MatiPardoE/CoffeeScale/7.Maqueta3D/README.md

# CoffeeScale

## Link del modelo 3d: [Coffee Scale](https://cad.onshape.com/documents/d358b07a945924bf26fd07b2/w/ca354c555462849854da787c/e/e62f95f824919a2ad912569b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)

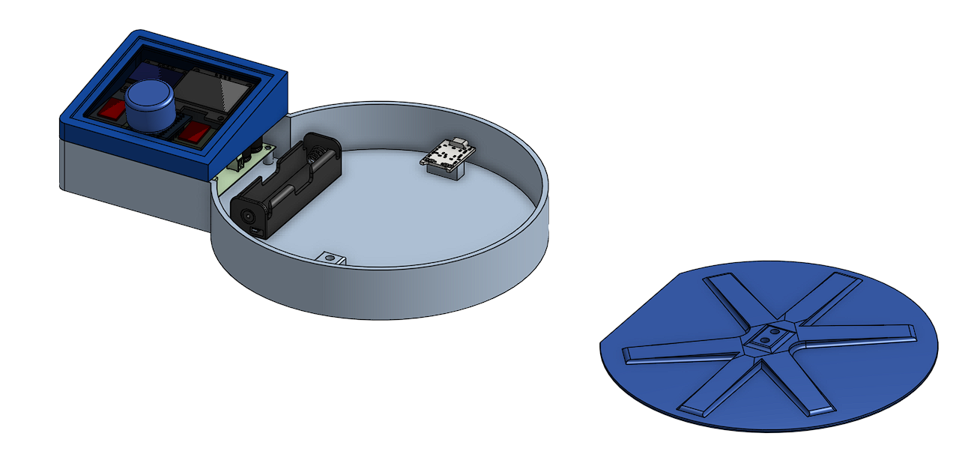
[picture p1: 7.Maqueta3D/ScreenShot.png]
Maqueta en 3d
