MatiPardoE/CoffeeScale/4.esquematico_pcb/CoffeeScale/Project Outputs for CoffeeScale/Entrega PCB/3D Picture.png

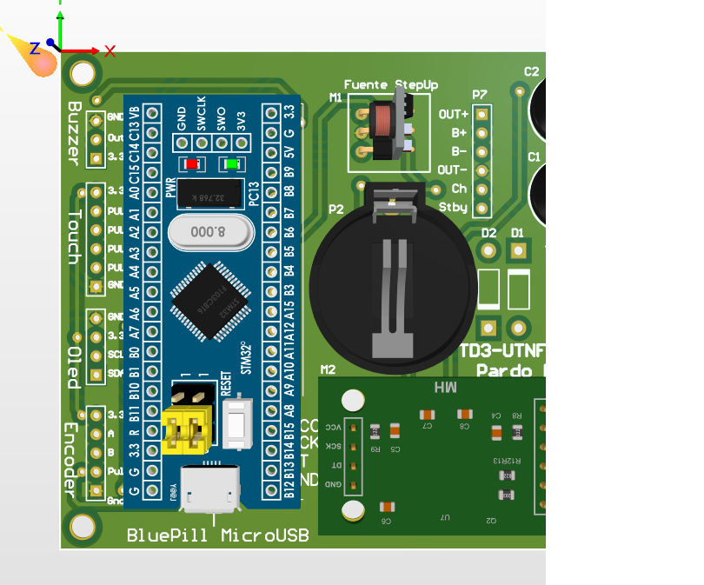
4.esquematico_pcb/CoffeeScale/Project Outputs for CoffeeScale/Entrega PCB/3D Picture.png
