MatiPardoE/CoffeeScale/1.preliminar/PriceList.xlsx

CoffeeScale
DATE
Done? | Item | Category | Quantity | Price | Extended Price | Brand/Comments
Yes | Sensor Touch | Electronic Module | 3 | $560.00 | $1680.00
Yes | Holder 18650 | Electronic Module | 1 | $999.00 | $999.00
Yes | Display Oled 1.3 | Electronic Module | 1 | $4419.00 | $4419.00
Yes | TP4056 Type C | Electronic Module | 1 | $1039.00 | $1039.00
Yes | Load Cell 3Kg | Sensor | 1 | $2369.00 | $2369.00
Yes | HX711 | Electronic Module | 1 | $900.00 | $900.00
Yes | 18650 Battery | Power | 1 | $3400.00 | $3400.00
No | Buzzer Magntic 5V | Audio | 1 | $760.00 | $760.00 | https://articulo.mercadolibre.com.ar/MLA-705919933-modulo-buzzer-activo-3v3-5v-zumbador-arduino-nubbeo-_JM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
 |  |  |  |  | $0.00
 |  |  |  |  | $0.00
 |  |  |  |  | $0.00
 |  |  |  |  | $0.00
 |  |  |  |  | $0.00
 |  |  |  |  | $0.00
 |  |  |  |  | $0.00
 |  |  |  |  | $0.00
 |  |  |  |  | $0.00
 |  |  |  |  | $0.00
 |  |  |  |  | $0.00
 |  |  |  |  | $0.00
 |  |  |  |  | $0.00
 |  |  |  |  | $0.00
 |  |  |  |  | $0.00
 |  |  |  |  | $0.00
 |  |  |  |  | $0.00
 |  |  |  |  | $0.00
 |  |  |  |  | $0.00
 |  |  |  |  | $15566.00
