MatiPardoE/CoffeeScale/4.esquematico_pcb/CoffeeScale/OwnComponents/coffeeBean.png

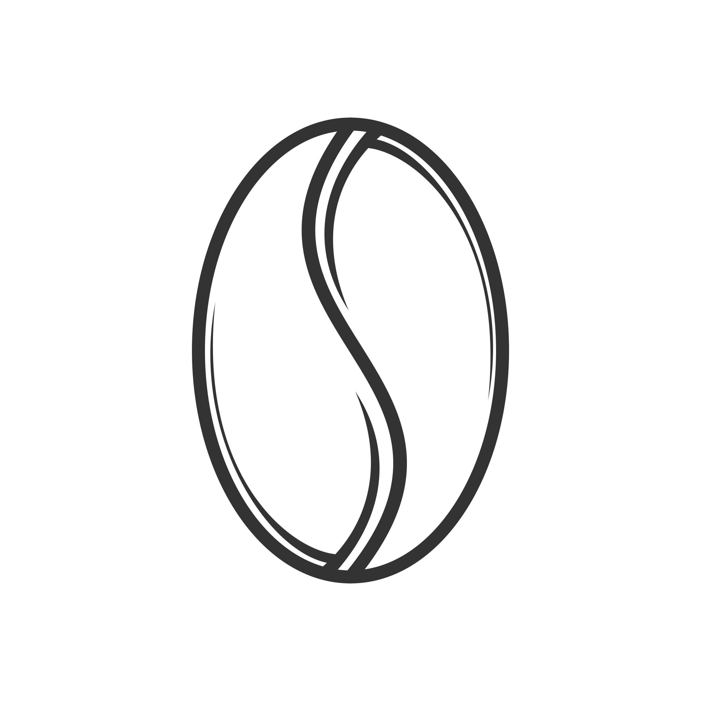
4.esquematico_pcb/CoffeeScale/OwnComponents/coffeeBean.png
