MatiPardoE/CoffeeScale/7.Maqueta3D/3d Maqueta para Imprimir/CoSc Full - Tapa Extension.stl

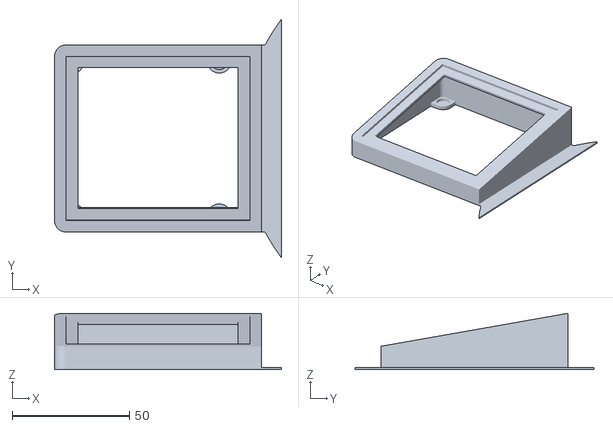
[picture p8: CAD file, 2023-10-10]
7.Maqueta3D/3d Maqueta para Imprimir/CoSc Full - Tapa Extension.stl
97.0 x 102.0 x 24.1
