MatiPardoE/CoffeeScale/7.Maqueta3D/3d Maqueta para Imprimir/CoSc Full - Plataforma.stl

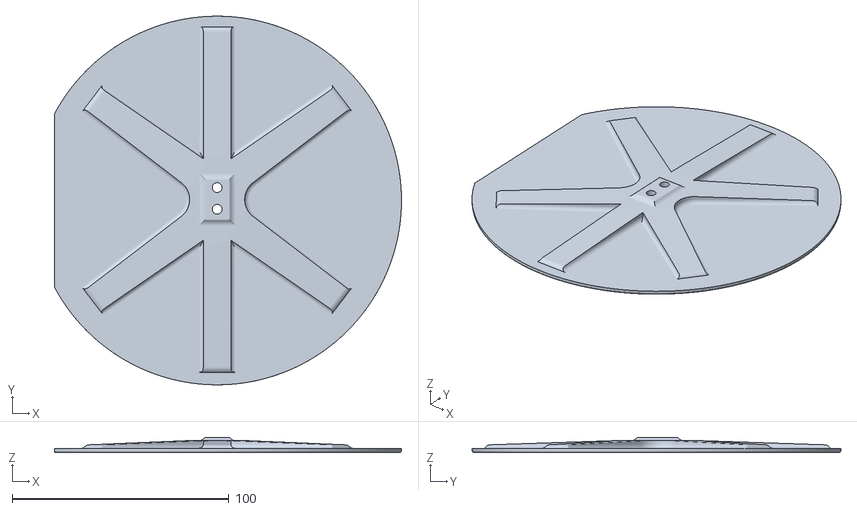
[picture p9: CAD file, 2023-09-01]
7.Maqueta3D/3d Maqueta para Imprimir/CoSc Full - Plataforma.stl
160.0 x 170.0 x 7.00
