MatiPardoE/CoffeeScale/7.Maqueta3D/3d Maqueta para Imprimir/CoSc Full - Base.stl

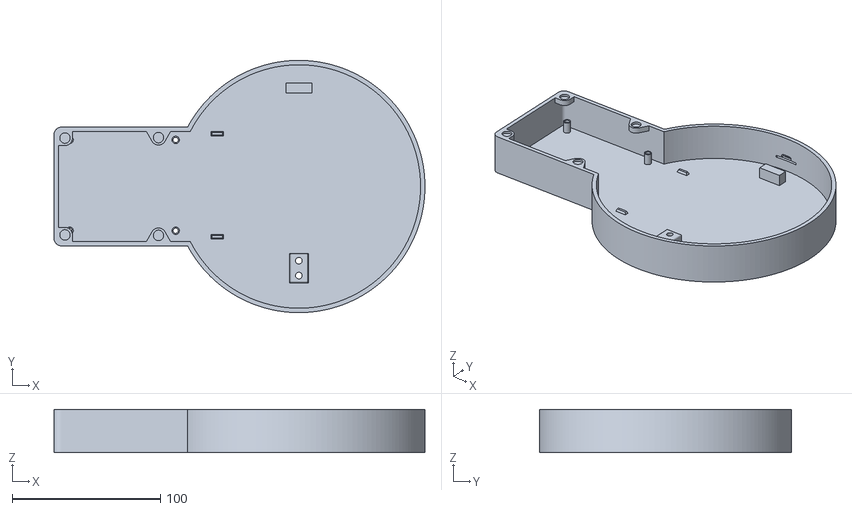
[picture p10: CAD file, 2023-09-01]
7.Maqueta3D/3d Maqueta para Imprimir/CoSc Full - Base.stl
250.0 x 170.0 x 29.0
