MatiPardoE/CoffeeScale/4.esquematico_pcb/CoffeeScale/OwnComponents/3d Model/HX711 (1).step

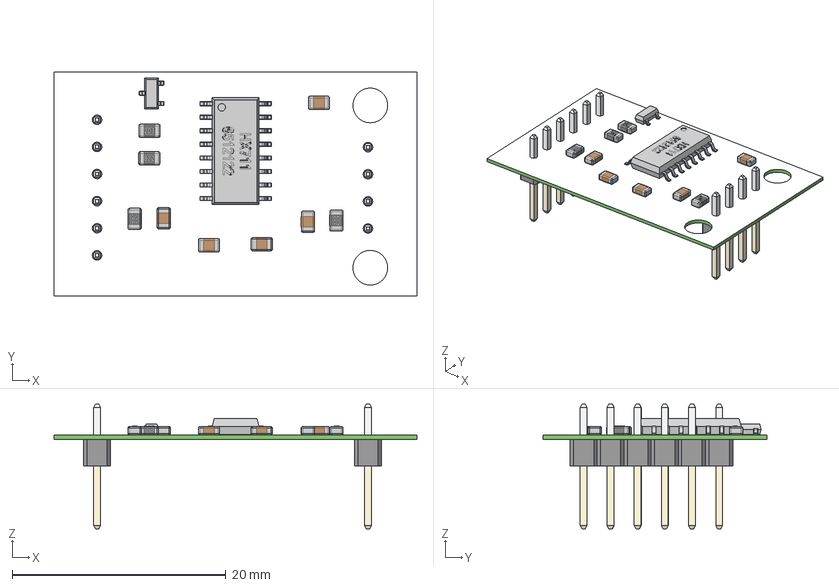
[picture p12: CAD file, 2023-08-29]
4.esquematico_pcb/CoffeeScale/OwnComponents/3d Model/HX711 (1).step
34.0 x 21.0 x 11.7 mm
placa
base_HX711
pino_HX711 x 16
RESISTOR_SMD_122 x 2
RESISTOR_SMD_822
RESISTOR_SMD_203
CAPACITOR_805 x 5
TRANSISTOR_SOT23
PINO_SOT23 x 3
Plastic
Pin Bottom
Pin Top
Plastic_1
Pin Bottom_1
Pin Top_1
