MatiPardoE/CoffeeScale/7.Maqueta3D/3d Maqueta para Imprimir/Encoder tapa - Part 1.stl

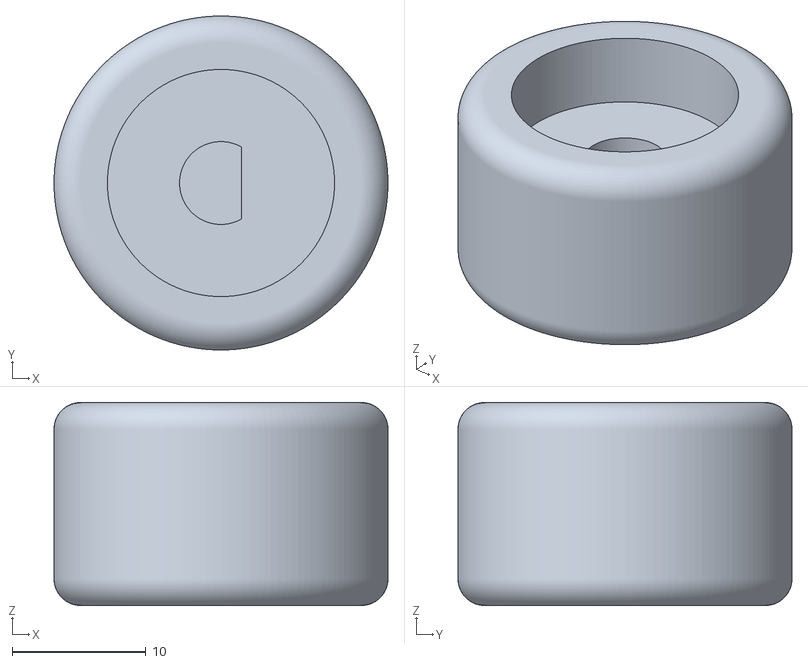
[picture p13: CAD file, 2023-10-10]
7.Maqueta3D/3d Maqueta para Imprimir/Encoder tapa - Part 1.stl
25.0 x 25.0 x 15.2
