MatiPardoE/CoffeeScale/7.Maqueta3D/3d Models/TTP223 Button Module.step

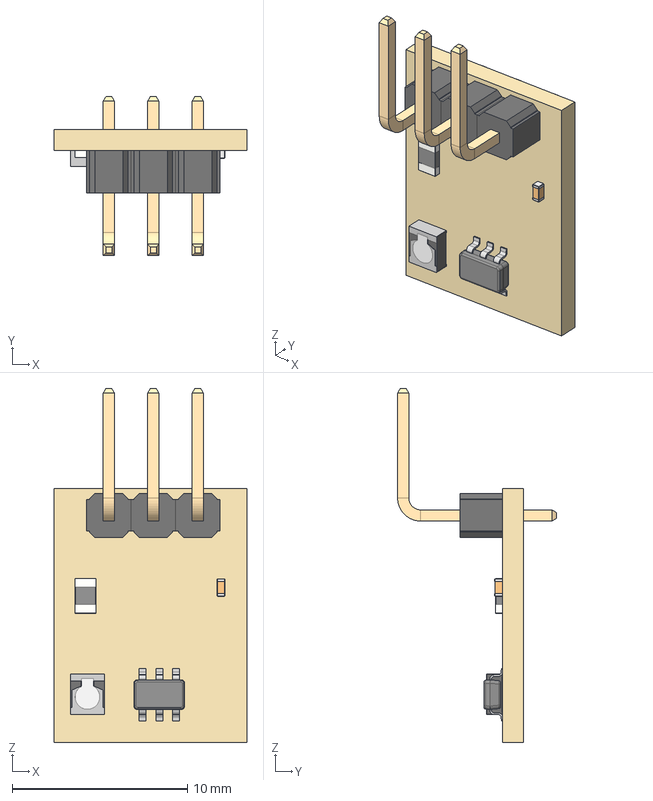
[picture p14: CAD file, 2023-09-01]
7.Maqueta3D/3d Models/TTP223 Button Module.step
11.0 x 9.07 x 20.2 mm
SMD LEDmidled-mini_l2-3_w1-95_h0-9
TTP223-BA6
R0805
pins x3
