MatiPardoE/CoffeeScale/7.Maqueta3D/3d Models/Geekcreit 1.3 Inch 4Pin.step

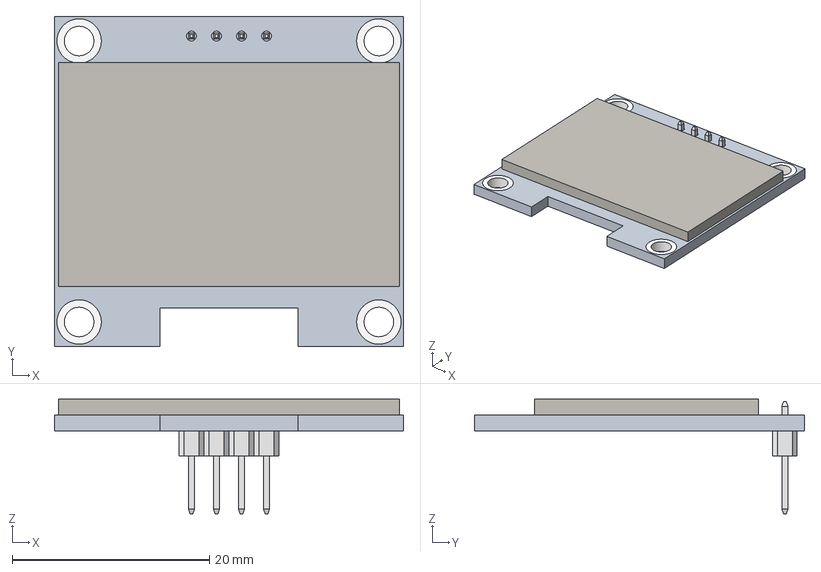
[picture p15: CAD file, 2023-09-01]
7.Maqueta3D/3d Models/Geekcreit 1.3 Inch 4Pin.step
35.4 x 33.5 x 11.6 mm
2.54mm_pin_header x 4
