MatiPardoE/CoffeeScale/7.Maqueta3D/3d Models/Rotary Encoder.step

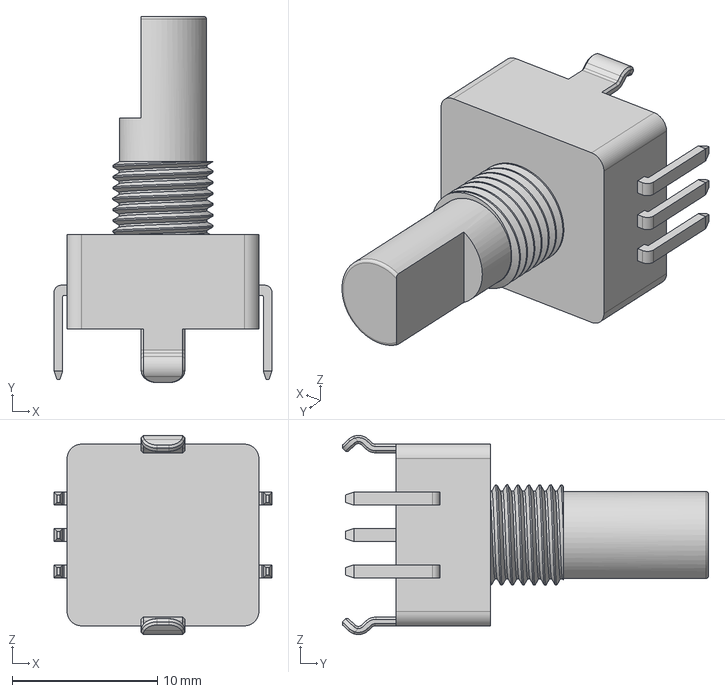
[picture p16: CAD file, 2023-09-01]
7.Maqueta3D/3d Models/Rotary Encoder.step
15.0 x 25.2 x 13.7 mm
