MatiPardoE/CoffeeScale/7.Maqueta3D/3d Models/weight sensor FHDA.STEP

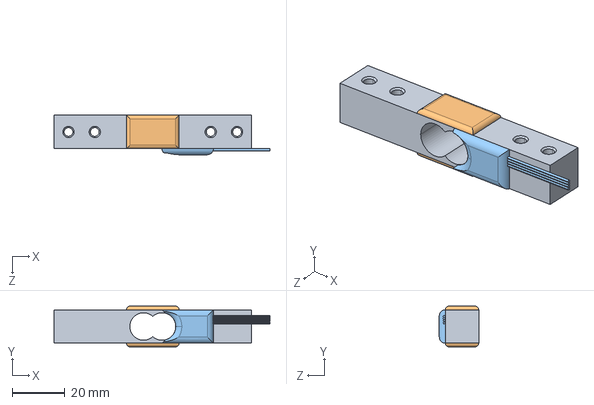
[picture p18: CAD file, 2023-08-29]
7.Maqueta3D/3d Models/weight sensor FHDA.STEP
82.0 x 15.5 x 15.0 mm
