MatiPardoE/CoffeeScale/7.Maqueta3D/3d Models/encoder.stl

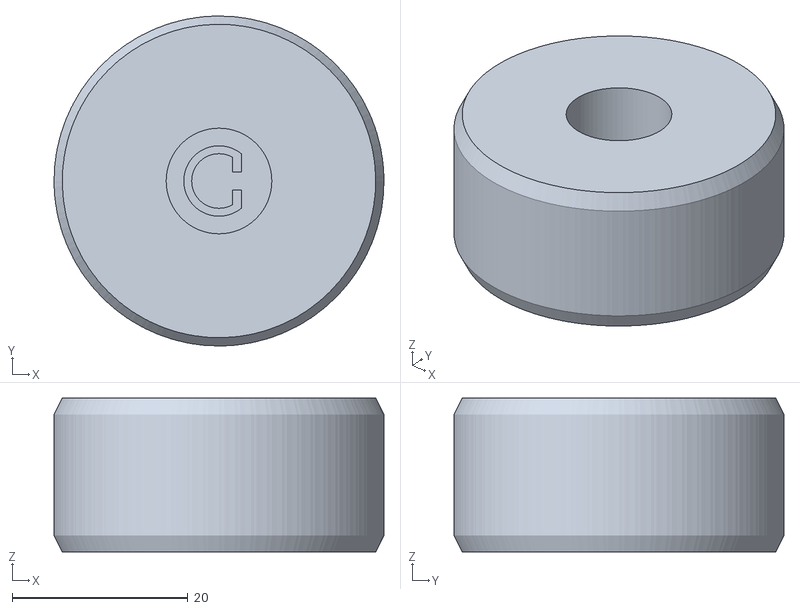
[picture p19: CAD file, 2023-08-29]
7.Maqueta3D/3d Models/encoder.stl
37.5 x 37.5 x 17.5
