MatiPardoE/CoffeeScale/7.Maqueta3D/3d Models/18650 battery single enclosure.STEP

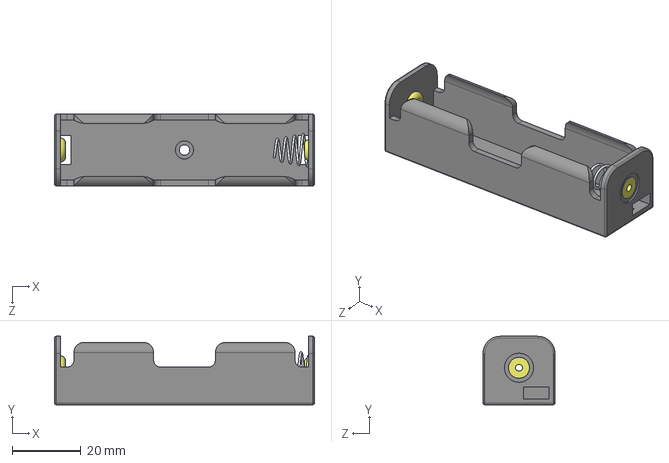
[picture p20: CAD file, 2023-09-01]
7.Maqueta3D/3d Models/18650 battery single enclosure.STEP
75.9 x 20.0 x 21.0 mm
