MatiPardoE/CoffeeScale/4.esquematico_pcb/CoffeeScale/Project Outputs for CoffeeScale/Entrega PCB/InformePCB.pdf

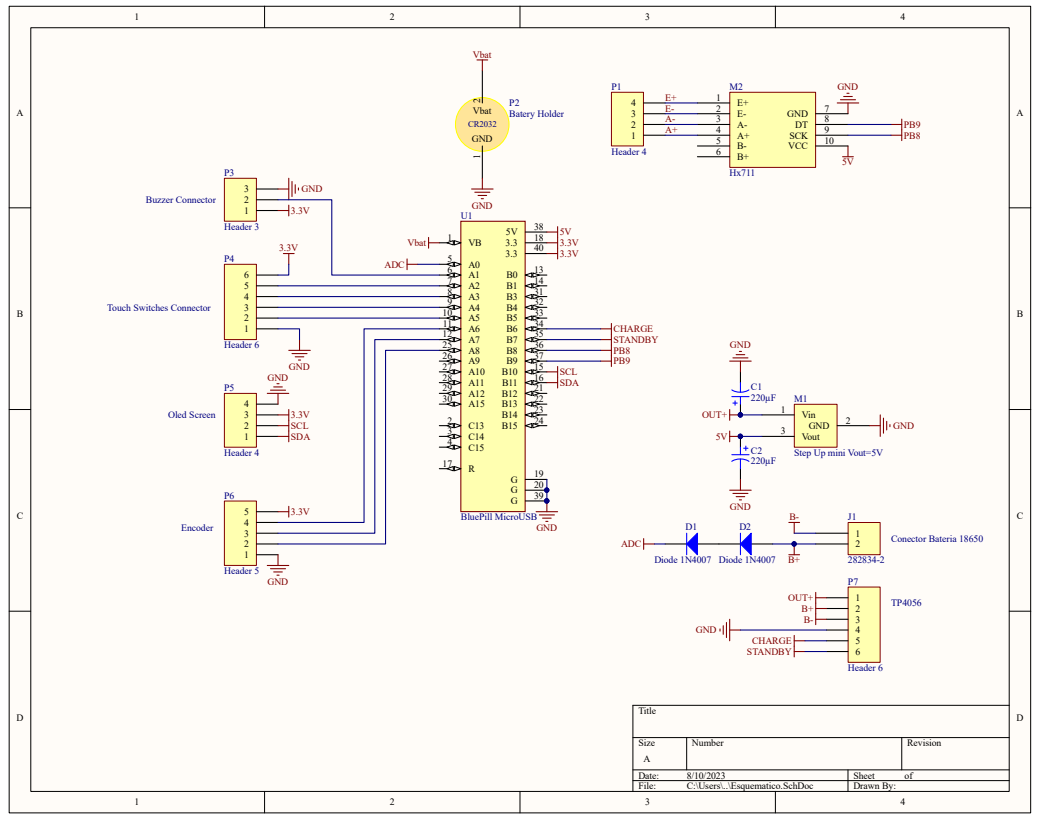
[picture p21: page 1]

Step Up mini Vout=5V

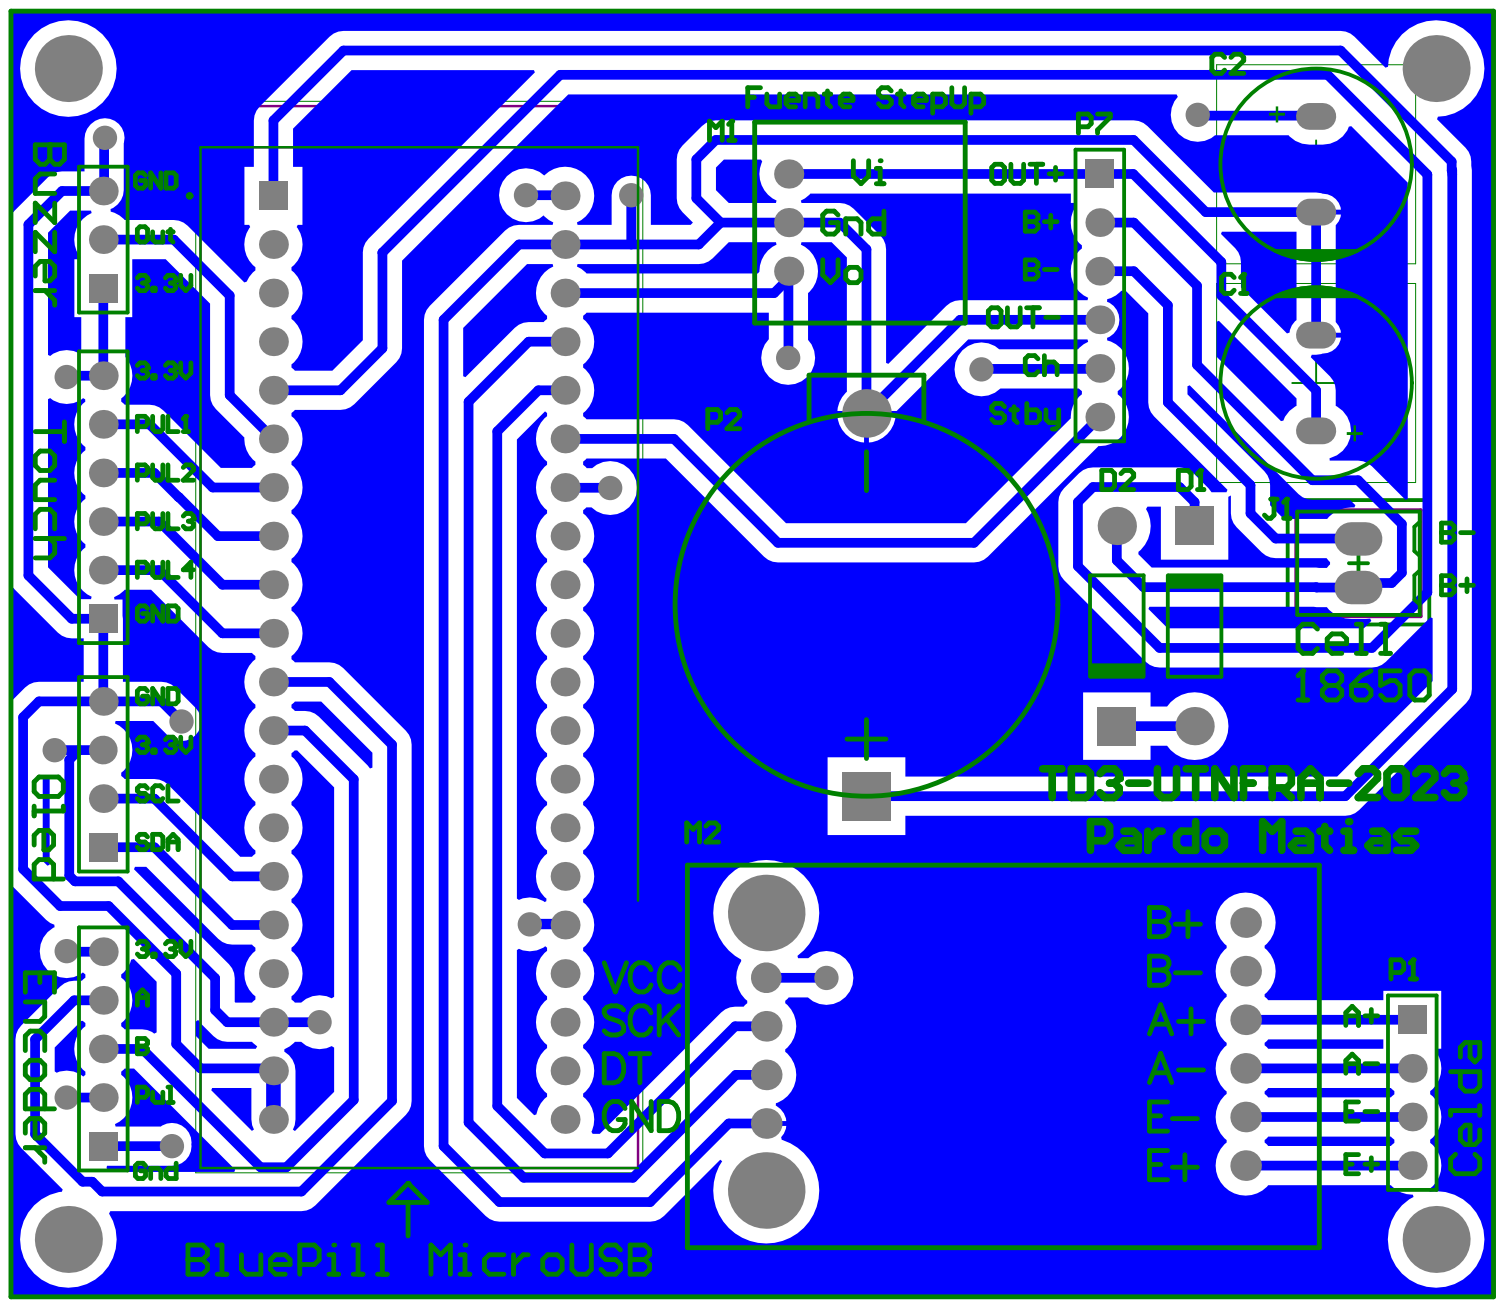
[picture p22: page 2]

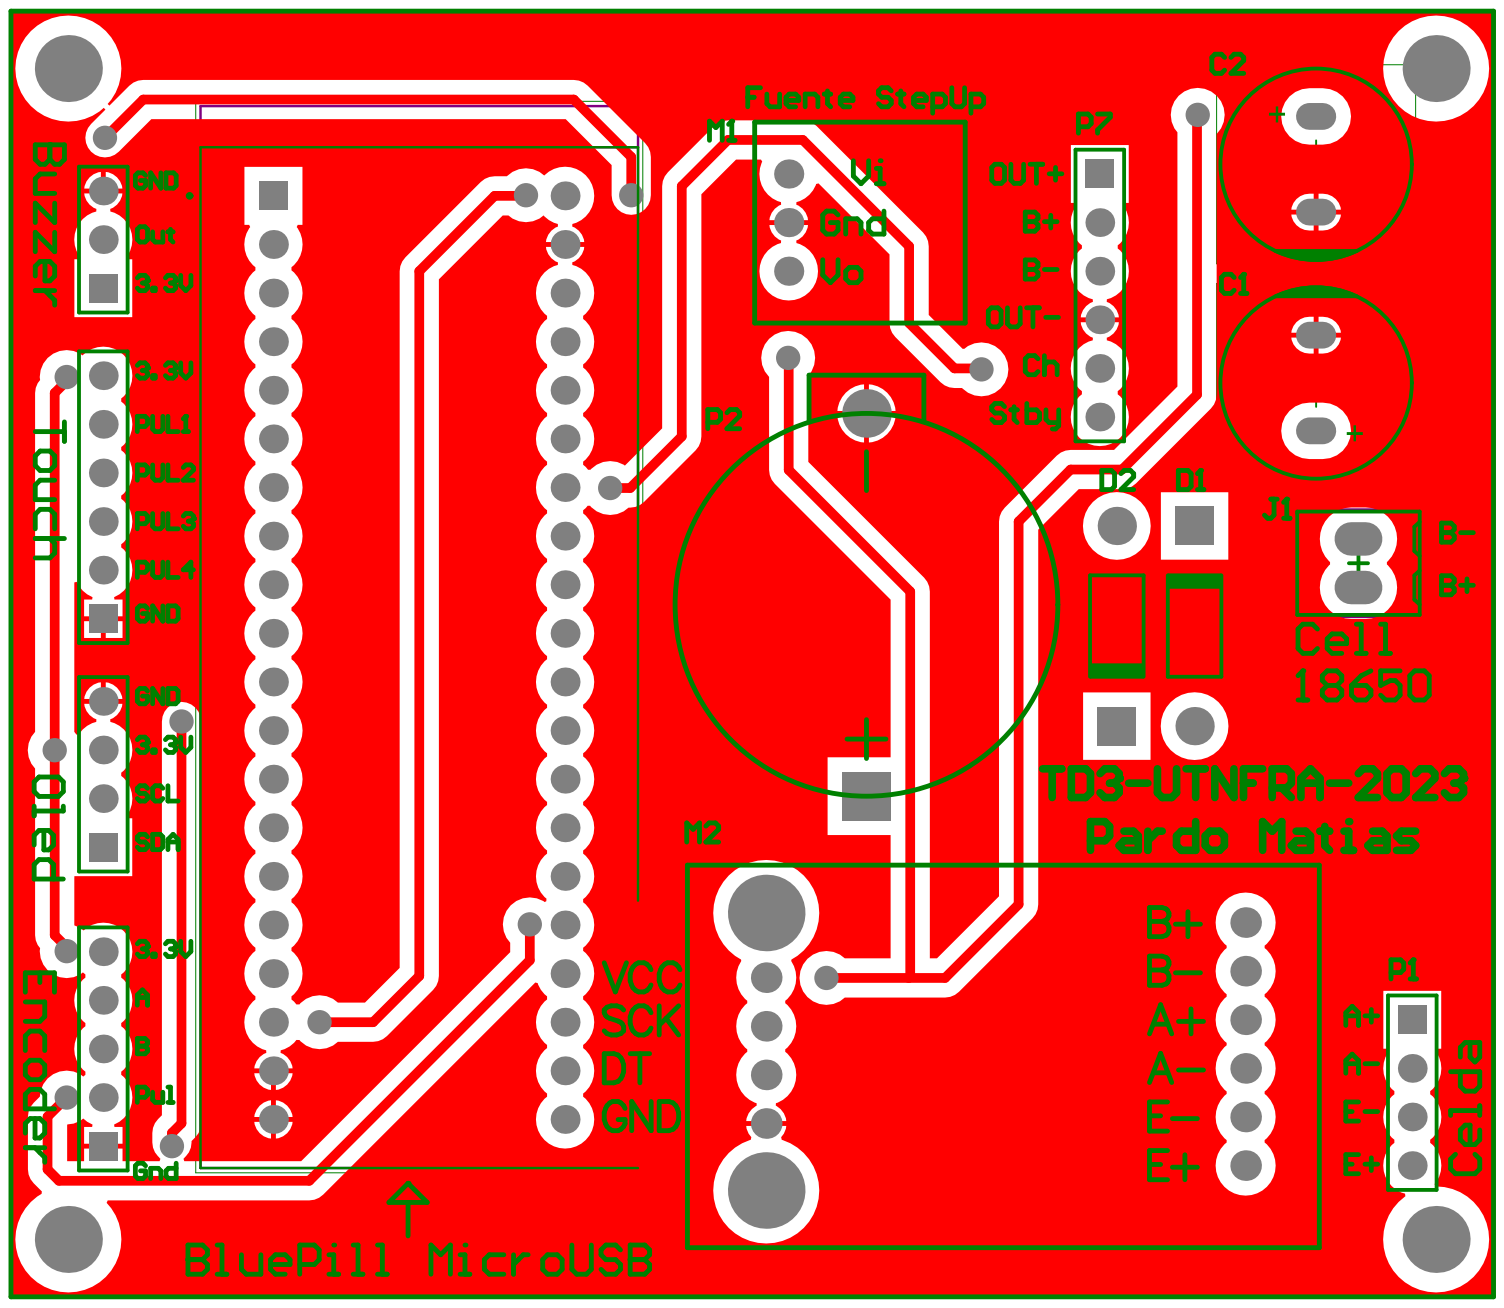
[picture p23: page 3]
