MatiPardoE/CoffeeScale/4.esquematico_pcb/CoffeeScale/Project Outputs for CoffeeScale/Schematic Print/Schematic.PDF

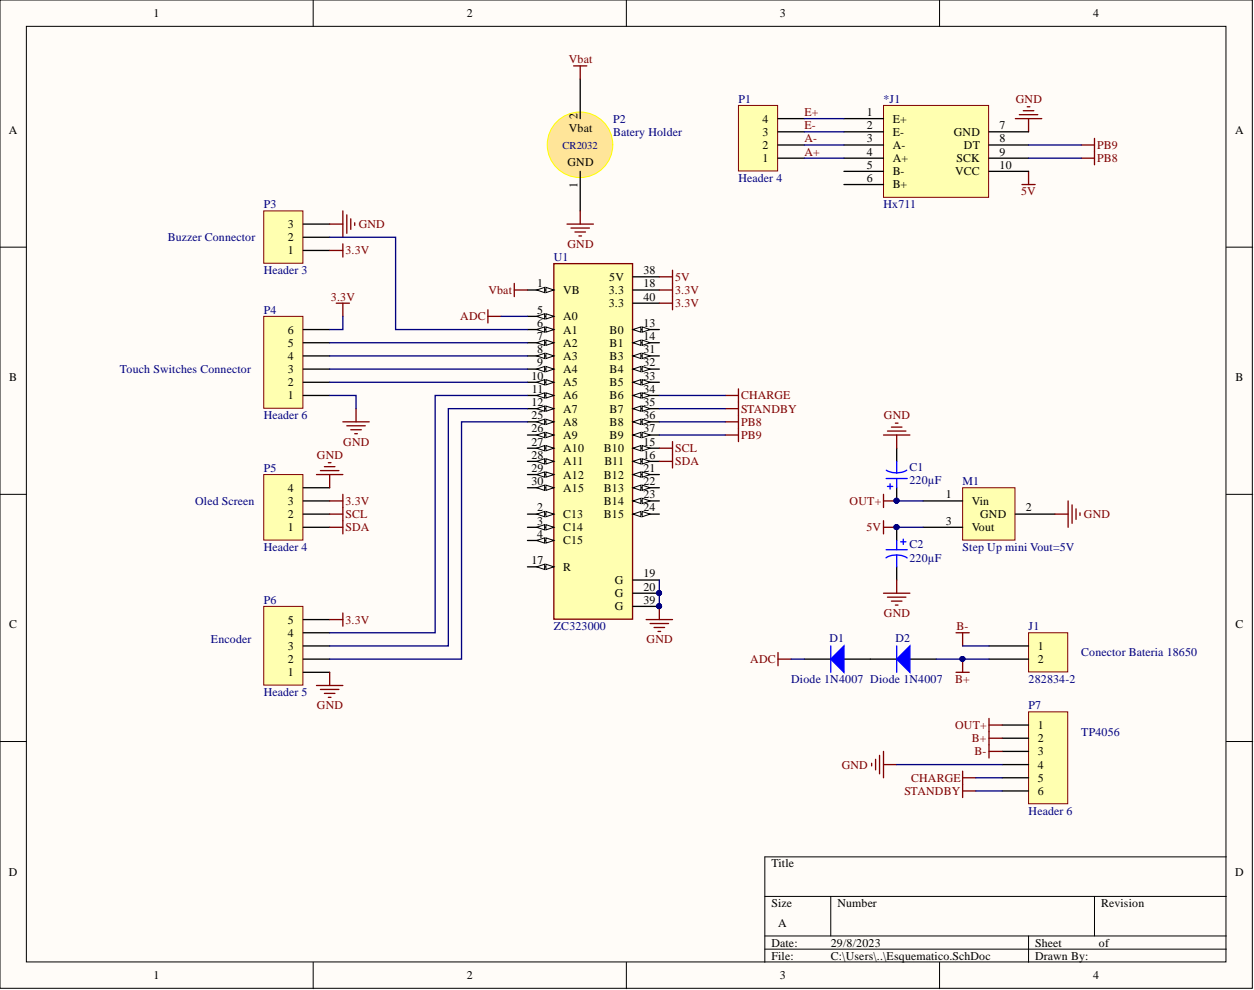
[picture p24: page 1]

A6 11
A7 12
A8 25

GND | A9 26

Step Up mini Vout=5V
