MatiPardoE/CoffeeScale/4.esquematico_pcb/CoffeeScale/Project Outputs for CoffeeScale/Entrega PCB/ESQUEMATICO.pdf

Step Up mini Vout=5V
