MatiPardoE/CoffeeScale/4.esquematico_pcb/CoffeeScale/Project Outputs for CoffeeScale/Job1.PDF

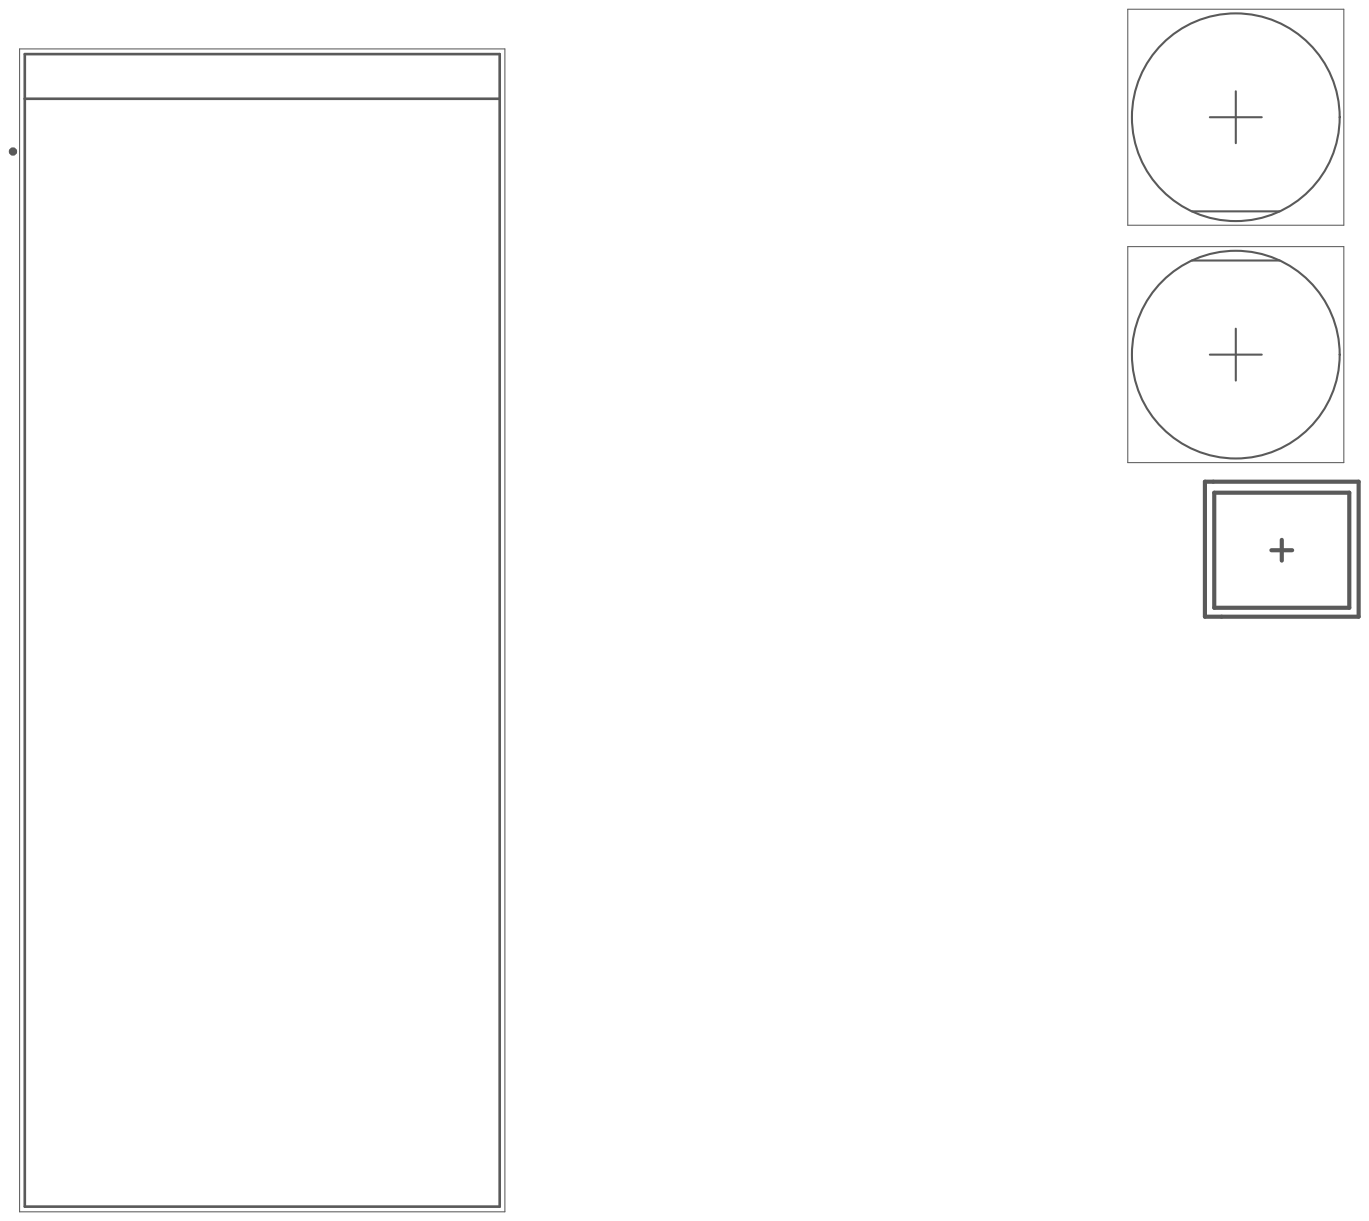
[picture p25: page 1]

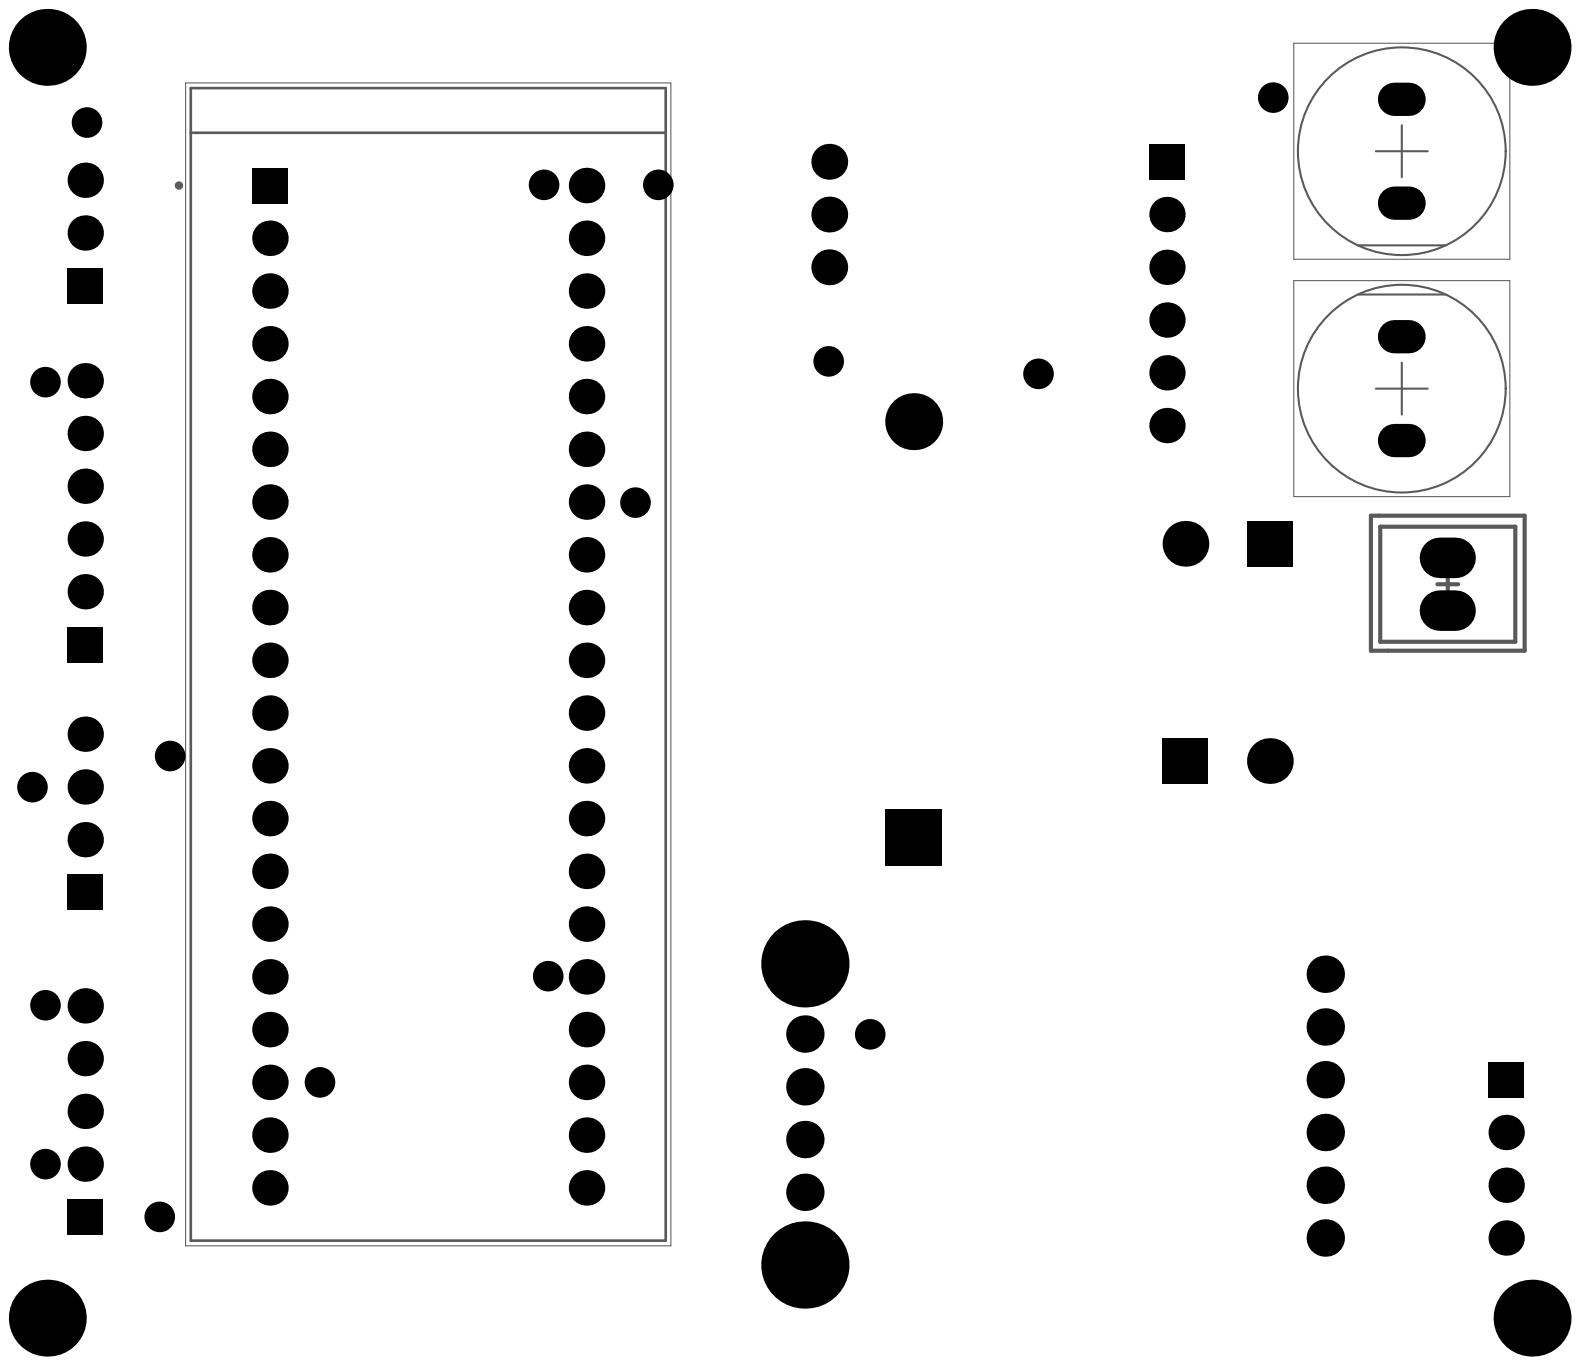
[picture p26: page 3]
