MatiPardoE/CoffeeScale/(list of files, drawings)

Other design files:
4.esquematico_pcb/CoffeeScale/CoffeeScale.PrjPcb
4.esquematico_pcb/CoffeeScale/Esquematico.SchDoc
4.esquematico_pcb/CoffeeScale/OwnComponents/BateryHolder.PcbLib
4.esquematico_pcb/CoffeeScale/OwnComponents/BateryHolder.SchLib
4.esquematico_pcb/CoffeeScale/OwnComponents/modulos/modulosSchLib.SchLib
4.esquematico_pcb/CoffeeScale/PCB.PcbDoc
