MatiPardoE/CoffeeScale/3.workspace/CoffeeScale/Core/Src/main.c

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
/* Includes ------------------------------------------------------------------*/
#include "main.h"

/* USER CODE BEGIN Includes */
#include "FreeRTOS.h"
#include "task.h"
#include "ssd1306.h"
#include "ssd1306_fonts.h"
#include "stdio.h"
/* USER CODE END Includes */

I2C_HandleTypeDef hi2c2;

TIM_HandleTypeDef htim3;

void SystemClock_Config(void);
static void MX_GPIO_Init(void);
static void MX_I2C2_Init(void);
static void MX_TIM3_Init(void);
/* USER CODE BEGIN 0 */
static void ShowScreen( void *pvParameters) {

	char str[50];  // Declaramos un arreglo de caracteres para almacenar el resultado

	ssd1306_Select(SH1106_bigOLED);
	ssd1306_Fill(Black);
	ssd1306_UpdateScreen();
	ssd1306_Select(SSD1306_smallOLED);
	ssd1306_Fill(Black);
	ssd1306_UpdateScreen();


    while (1){
    	sprintf(str,"Encoder: %d",((int)(TIM3->CNT)>>2));

    	ssd1306_Select(SH1106_bigOLED);
    	ssd1306_SetCursor(0, 0);
    	ssd1306_WriteString(str, Font_7x10, White);
    	ssd1306_UpdateScreen();

    	ssd1306_Select(SSD1306_smallOLED);
    	ssd1306_SetCursor(0, 0);
    	ssd1306_WriteString(str, Font_7x10, White);
    	ssd1306_UpdateScreen();


    }

}
/* USER CODE END 0 */

/**
  * @brief  The application entry point.
  * @retval int
  */
int main(void)
{
  /* MCU Configuration--------------------------------------------------------*/

  /* Reset of all peripherals, Initializes the Flash interface and the Systick. */


	HAL_Init();

  /* Configure the system clock */
  SystemClock_Config();

  /* Initialize all configured peripherals */
  MX_GPIO_Init();
  MX_I2C2_Init();
  MX_TIM3_Init();
  /* USER CODE BEGIN 2 */
  HAL_TIM_Encoder_Start(&htim3, TIM_CHANNEL_ALL);

  ssd1306_Select(SSD1306_smallOLED);
  ssd1306_Init();
  ssd1306_Select(SH1106_bigOLED);
  ssd1306_Init();

  xTaskCreate(ShowScreen,                  	// Nombre de la función que se ejecutará como tarea
			  "",                      	// Nombre de la tarea (cadena vacía)
			  configMINIMAL_STACK_SIZE,	// Tamaño de la pila asignado a la tarea
			  NULL,                    	// Puntero a información que se pasará como argumento a la tarea
			  3,                       	// Prioridad de la tarea
			  NULL);    	// Puntero a variable para almacenar el identificador de la tarea


  vTaskStartScheduler();
  /* USER CODE END 2 */

  /* Infinite loop */
  /* USER CODE BEGIN WHILE */
  while (1)
  {
    /* USER CODE END WHILE */

    /* USER CODE BEGIN 3 */

  }
  /* USER CODE END 3 */
}

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
/**
  * @brief  Period elapsed callback in non blocking mode
  * @note   This function is called  when TIM1 interrupt took place, inside
  * HAL_TIM_IRQHandler(). It makes a direct call to HAL_IncTick() to increment
  * a global variable "uwTick" used as application time base.
  * @param  htim : TIM handle
  * @retval None
  */
void HAL_TIM_PeriodElapsedCallback(TIM_HandleTypeDef *htim)
{
  if (htim->Instance == TIM1) {
    HAL_IncTick();
  }
}

/**
  * @brief  This function is executed in case of error occurrence.
  * @retval None
  */
void Error_Handler(void)
{
  /* USER CODE BEGIN Error_Handler_Debug */
  /* User can add his own implementation to report the HAL error return state */
  __disable_irq();
  while (1)
  {
  }
  /* USER CODE END Error_Handler_Debug */
}

#ifdef  USE_FULL_ASSERT
/**
  * @brief  Reports the name of the source file and the source line number
  *         where the assert_param error has occurred.
  * @param  file: pointer to the source file name
  * @param  line: assert_param error line source number
  * @retval None
  */
void assert_failed(uint8_t *file, uint32_t line)
{
  /* USER CODE BEGIN 6 */
  /* User can add his own implementation to report the file name and line number,
     ex: printf("Wrong parameters value: file %s on line %d\r\n", file, line) */
  /* USER CODE END 6 */
}
#endif /* USE_FULL_ASSERT */

/************************ (C) COPYRIGHT STMicroelectronics *****END OF FILE****/
