MatiPardoE/CoffeeScale/(commit log)

2023-06-15 Info Previa + Lista de Precios
    [PriceList.xlsx]
2023-08-29 Agrego 3d Draft y PCB, el pcb ya estan hechas las vias y los pads de sujecion
    [BateryHolder.PcbLib, BateryHolder.SchLib, CoffeeScale.PrjPcb, Esquematico.SchDoc, HX711 (1).step, PCB.PcbDoc, encoder.stl, modulosSchLib.SchLib]
2023-09-01 Se agrega todo el diseño 3d para impresion
    [18650 battery single enclosure.STEP, CoSc Full - Base.stl, CoSc Full - Encoder Tapa.stl, CoSc Full - Plataforma.stl, CoSc Full - Tapa Extension.stl, CoffeeScale.PrjPcb, Geekcreit 1.3 Inch 4Pin.step, PCB.PcbDoc]
2023-09-01 Agrego 3d completo para readme
2023-09-01 Vemos is anda el renderizado en el readme
2023-09-13 Se exportaron los Gerbers para mandar a producir a china
    [CoffeeScale.PrjPcb, PCB.PcbDoc, modulosSchLib.SchLib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]
2023-09-22 Modificacion Tapa encoder 3d post primera impresion y nuevo anexo sobre diseño de balanzas
    [CoSc Full - Encoder Tapa.stl]
2023-10-10 First STM32 project with FreeRtos and Showing Somethin in Oled
    [BateryHolder.PcbLib, CoSc Full - Encoder Tapa.stl, CoSc Full - Tapa Extension.stl, CoffeeScale.PrjPcb, Encoder tapa - Part 1.stl, Esquematico.SchDoc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]
2023-10-20 Modulo encoder funcionando a traves de los 2 canales del timer 3, falta agregar el boton por interrupcion y hacer una pequeña libreria. Tambien se arreglo un problema de offset en la pantalla grande 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
    [CoffeeScale.ioc, main.c]
